jvedder/Biploar-power-supply-KiCAD/cnc/Original Carbide Copper Output/Carbide-Copper-image.png

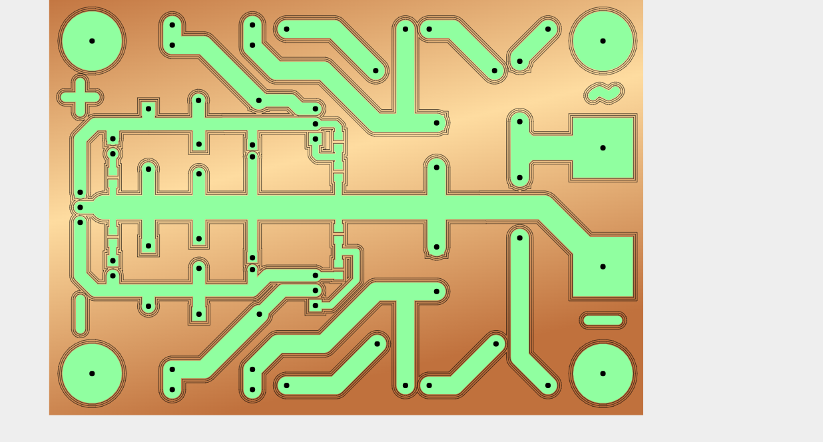
cnc/Original Carbide Copper Output/Carbide-Copper-image.png
