jvedder/Biploar-power-supply-KiCAD/README.md

# Biploar-power-supply-KiCAD
A KiCAD PCB project for a simple linear bipolar power supply (+/-15V) from a 24V single-phase transformer.

This is a work in progress.  

MIT License
