jvedder/Biploar-power-supply-KiCAD/pdf/Bipolar power supply assembly.pdf

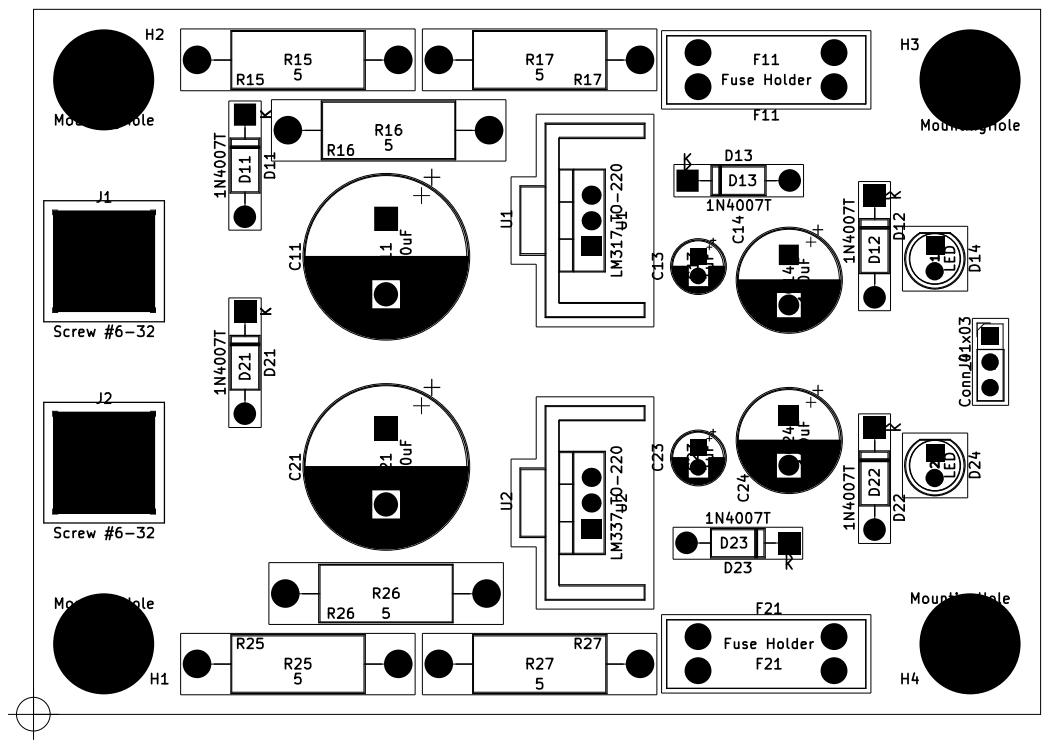
[picture p2: page 1]
