jvedder/Biploar-power-supply-KiCAD/pdf/Bipolar power supply pcb.pdf

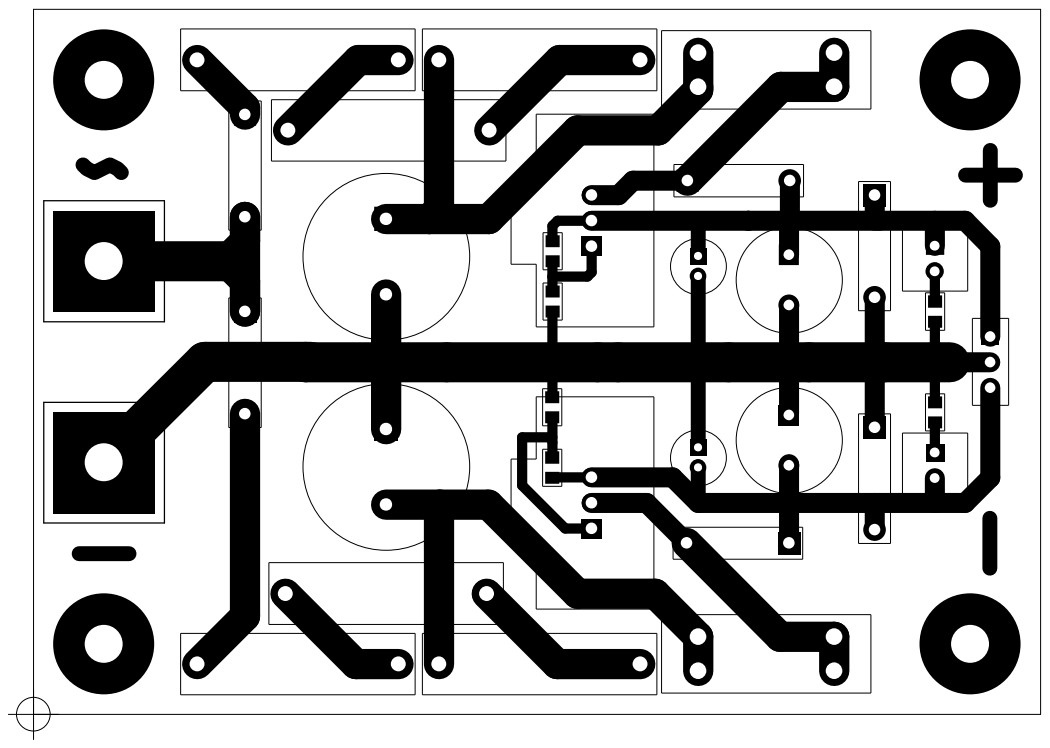
[picture p3: page 1]
