jvedder/Biploar-power-supply-KiCAD/pdf/Bipolar power supply schematc.pdf

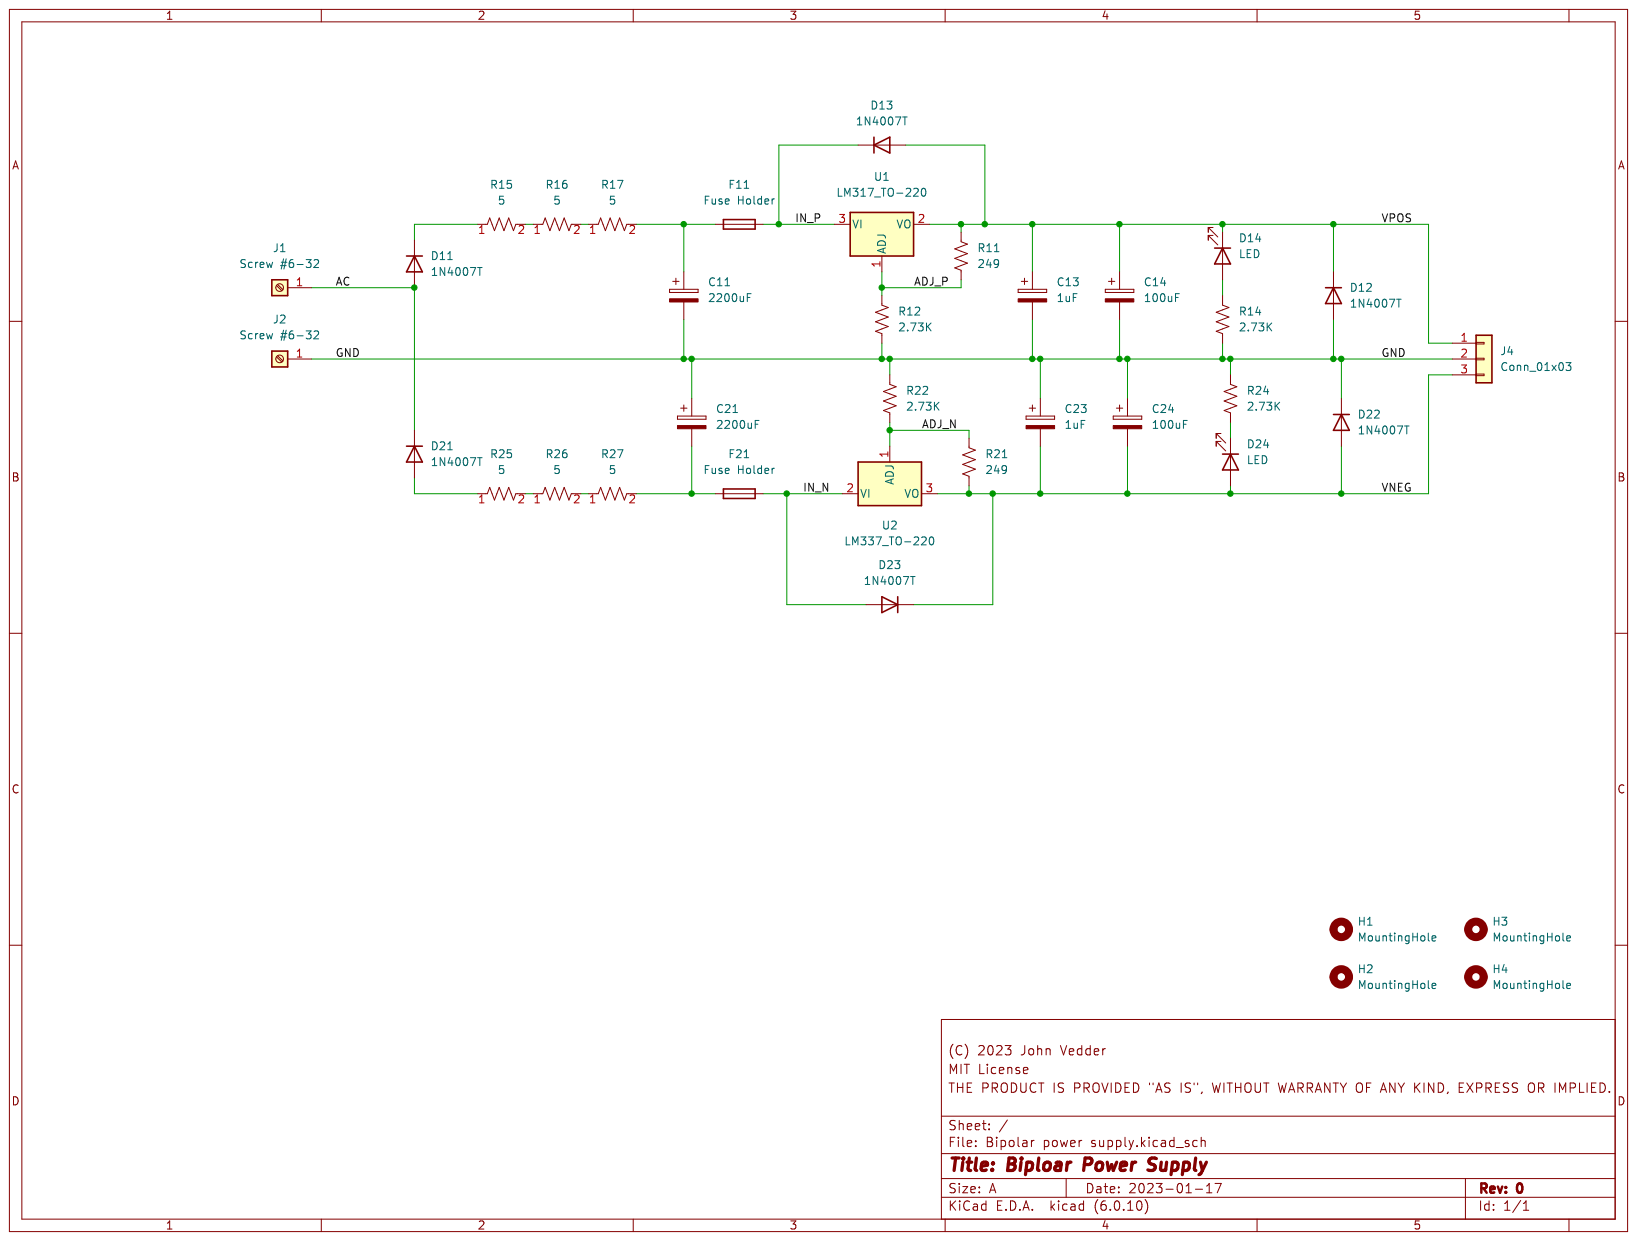
[picture p4: page 1]
