jvedder/Biploar-power-supply-KiCAD/LTSpiceXVII/Parameteric Half-wave Rectifier test current source load.asc

.RIN2: res; {RIN}
C1: cap; 2200µF; V=50V Irms=3.375 Rser=60m
C2: cap; 2200µF; V=50V Irms=3.375 Rser=60m
C3: cap; 100µF
D1: diode; 1N4007
D2: diode; 1N4007
D3: diode; 1N4007
I1: current; {IOUT}
R1: res; 125
R2: res; {(VOUT * 100) - 125}
RIN: res; {RIN}
RL1: res; {VOUT / IOUT}
U1: LT317A
V1: voltage; SINE(0 {AC_PEAK} 60)
Named nets: 0, OUT, IN, AC, ADJ, PRE, IN2, PRE2
1000V 1A
.tran 1s
.param AC_RMS=27.5V
.param AC_PEAK={AC_RMS * SQRT(2)}
.param VOUT=15V
.param IOUT=250mA
.param RIN=15
.meas PARAM_R2_VALUE PARAM ((VOUT*100)-125)
.meas PARAM_AC_RMS PARAM AC_RMS
.meas PARAM_AC_PEAK PARAM AC_PEAK
.meas PARAM_VOUT PARAM VOUT
.meas PARAM_IOUT PARAM IOUT
.meas PARAM_RIN PARAM RIN
.meas U1_Pwr AVG V(ADJ)*Ix(U1:ADJ)+V(OUT)*Ix(U1:OUT)+V(IN)*Ix(U1:IN) FROM 0.9S TO 1S
.meas RIN_Pwr AVG V(PRE,IN)*I(RIN) FROM 0.9S TO 1S
.meas C1_Vpp PP V(IN) FROM 0.9S TO 1S
.meas C1_Ipp PP I(C1) FROM 0.9S TO 1S
.meas C1_Imax MAX I(C1)
.meas D1_Imax MAX I(D1)
.meas D1_Ipp PP I(D1) FROM 0.9S TO 1S
.meas D1_Pwr AVG V(AC,PRE)*I(D1) FROM 0.9S TO 1S
.meas D1_Iavg AVG I(D1) FROM 0.9S TO 1S
.meas IN_VMIN MIN V(IN) FROM 0.9S TO 1S
.meas IN_VMAX MAX V(IN) FROM 0.9S TO 1S
.meas IN_Vpp PP V(IN) FROM 0.9S TO 1S
.meas IN_Vavg AVG V(IN) FROM 0.9S TO 1S
.meas OUT_Vavg AVG V(OUT) FROM 0.9S TO 1S
.meas OUT_Iavg AVG I(RL1) FROM 0.9S TO 1S
.meas DROPOUT_Vmin PARAM IN_VMIN - VOUT
.meas DROPOUT_Vavg PARAM IN_VAVG - VOUT
Old Furnace transformer
Name plate 24V, 40VA
Fluke Measures 27.3V AC out
Scope measures 78.4V pk-pk = 39.2V pk = 27.5V RMS
 
Old Alarm Transformer
Name plate 16.5VAC 35VA
Fluke Measures 19.0V AC out
Scope measures 54,4V pk-pk = 27.2V pk = 19.23V RMS
.model 1N4007 d is = 1.43733E-008 n = 1.80829 rs = 0.0414712
+ eg = 1.11 xti = 3 tnom = 27
+ cjo = 2.8119E-011 vj = 0.700053 m = 0.346714 fc = 0.5
+ tt = 4.10886E-006 bv = 1100 ibv = 10 af = 1 kf = 0
1000V 1A
