jvedder/Biploar-power-supply-KiCAD/LTSpiceXVII/Parameteric Half-wave Rectifier with IdealRegulator.asc

C1: cap; 2200µF
C2: cap; 2200µF
C3: cap; 100µF
D1: schottky; RB068LAM100
R1: res; 125
R2: res; {(VOUT * 100) - 125}
R3: res; {RIN}
RL1: res; {VOUT / IOUT}
V1: voltage; SINE(0 {AC_PEAK} 60)
X1: IdealPosRegulator
Named nets: 0, OUT, IN, AC, ADJ, PRE
100V 2A
.tran 1S
.param AC_RMS=27.5V
.param AC_PEAK={AC_RMS * SQRT(2)}
.param VOUT=15V
.param IOUT=0.250A
.param RIN=10ohm
.meas PARAM_R2_VALUE PARAM ((VOUT*100)-125)
.meas PARAM_AC_RMS PARAM AC_RMS
.meas PARAM_AC_PEAK PARAM AC_PEAK
.meas PARAM_VOUT PARAM VOUT
.meas PARAM_IOUT PARAM IOUT
.meas PARAM_RIN PARAM RIN
.meas X1_Pwr AVG V(ADJ)*Ix(X1:ADJ)+V(IN)*Ix(X1:IN)+V(OUT)*Ix(X1:OUT) FROM 250mS TO 500mS
.meas R3_pwr AVG V(PRE,IN)*I(R3) FROM 0.9S TO 1S
.meas C1_Vpp PP V(IN) FROM 0.9S TO 1S
.meas C1_Ipp PP I(C1) FROM 0.9S TO 1S
.meas C1_Imax MAX I(C1)
.meas D1_Imax MAX I(D1)
.meas IN_VMIN MIN V(IN) FROM 0.9S TO 1S
.meas IN_VMAX MAX V(IN) FROM 0.9S TO 1S
.meas IN_Vpp PP V(IN) FROM 0.9S TO 1S
.meas IN_AVG AVG V(IN) FROM 0.9S TO 1S
.meas OUT_VAVG AVG V(OUT) FROM 0.9S TO 1S
.meas OUT_IAVG AVG I(RL1) FROM 0.9S TO 1S
.meas DROPOUT param {IN_VMIN - VOUT}
Old Furnace transformer
Name plate 24V, 40VA
Fluke Measures 27.3V AC out
Scope measures 78.4V pk-pk = 39.2V pk = 27.5V RMS
 
Old Alarm Transformer
Name plate 16.5VAC 35VA
Fluke Measures 19.0V AC out
Scope measures 54,4V pk-pk = 27.2V pk = 19.23V RMS
