jvedder/Biploar-power-supply-KiCAD/Bipolar power supply.kicad_pcb

## KiCad design Bipolar power supply.kicad_pcb (2023-01-18)

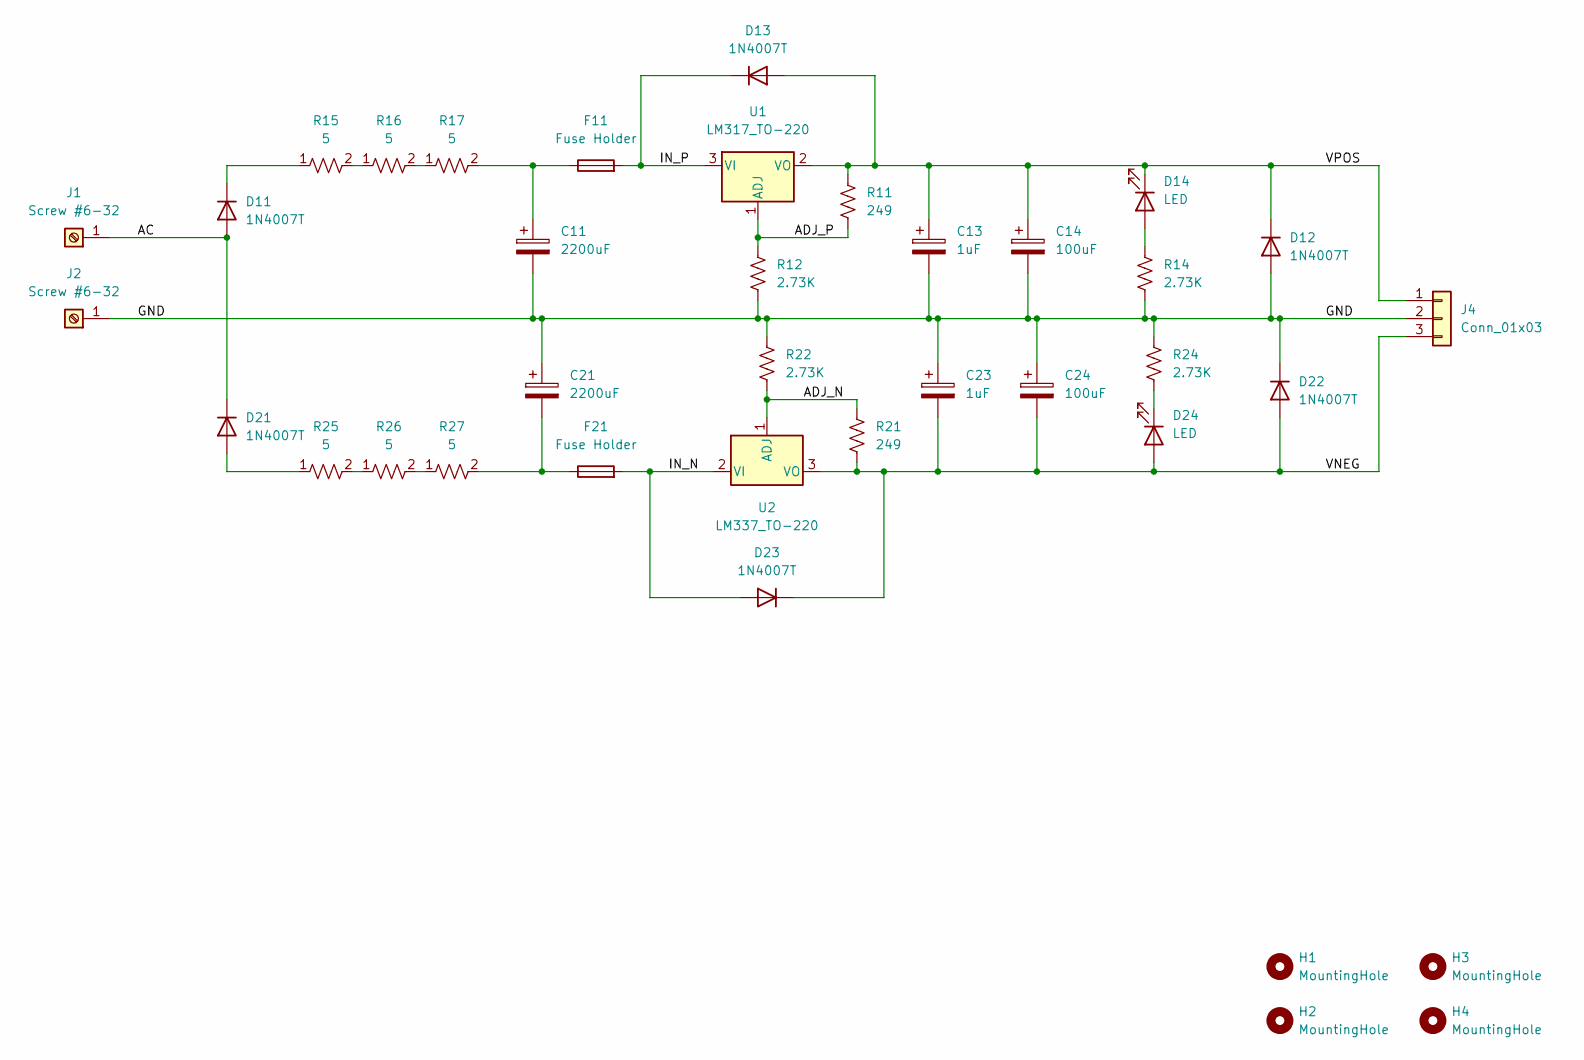
[picture p5: schematic Bipolar power supply.kicad_sch, Biploar Power Supply]

Parts:
C11, C21: 2200uF; CP_Radial_D16.0mm_P7.50mm
C13, C23: 1uF; CP_Radial_D5.0mm_P2.00mm
C14, C24: 100uF; CP_Radial_D10.0mm_P5.00mm
D11, D12, D13, D21, D22, D23: 1N4007T; D_DO-41_SOD81_P10.16mm_Horizontal
D14, D24: LED; LED_D5.0mm
F11, F21: Fuse Holder; FuseHolder_6.8x19.8mm_P3.4x13.5mm_Vetical
H1, H2, H3, H4: MountingHole; MountingHole_#6-32_Pad_10mm
J1, J2: Screw #6-32; ScrewTerminal_01x01_#6-32_10mm
J4: Conn_01x03; PinHeader_1x03_P2.54mm_Vertical
R11, R21: 249; R_0805_2012Metric_Pad1.20x1.40mm_HandSolder
R12, R14, R22, R24: 2.73K; R_0805_2012Metric_Pad1.20x1.40mm_HandSolder
R15, R16, R17, R25, R26, R27: 5; R_Axial_L13.1mm_D5.6mm_P20.0mm_Horizontal
U1: LM317_TO-220; TO-220-3_Vertical_Heatsink_19.1x9.7mm
U2: LM337_TO-220; TO-220-3_Vertical_Heatsink_19.1x9.7mm

Connections:
/AC: D11.2 (A), D21.1 (K), J1.1
/ADJ_N: R21.1, R22.2, U2.1 (ADJ)
/ADJ_P: R11.2, R12.1, U1.1 (ADJ)
/GND: C11.2, C13.2, C14.2, C21.1, C23.1, C24.1, D12.2 (A), D22.1 (K), J2.1, J4.2, R12.2, R14.2, R22.1, R24.1
/IN_N: D23.2 (A), F21.2, U2.2 (VI)
/IN_P: D13.1 (K), F11.2, U1.3 (VI)
/VNEG: C23.2, C24.2, D22.2 (A), D23.1 (K), D24.2 (A), J4.3, R21.2, U2.3 (VO)
/VPOS: C13.1, C14.1, D12.1 (K), D13.2 (A), D14.1 (K), J4.1, R11.1, U1.2 (VO)
unnamed: C11.1, F11.1, R17.2
unnamed: C21.2, F21.1, R27.2
unnamed: D14.2 (A), R14.1
unnamed: D24.1 (K), R24.2
unnamed: D11.1 (K), R15.1
unnamed: R15.2, R16.1
unnamed: R16.2, R17.1
unnamed: D21.2 (A), R25.1
unnamed: R25.2, R26.1
unnamed: R26.2, R27.1

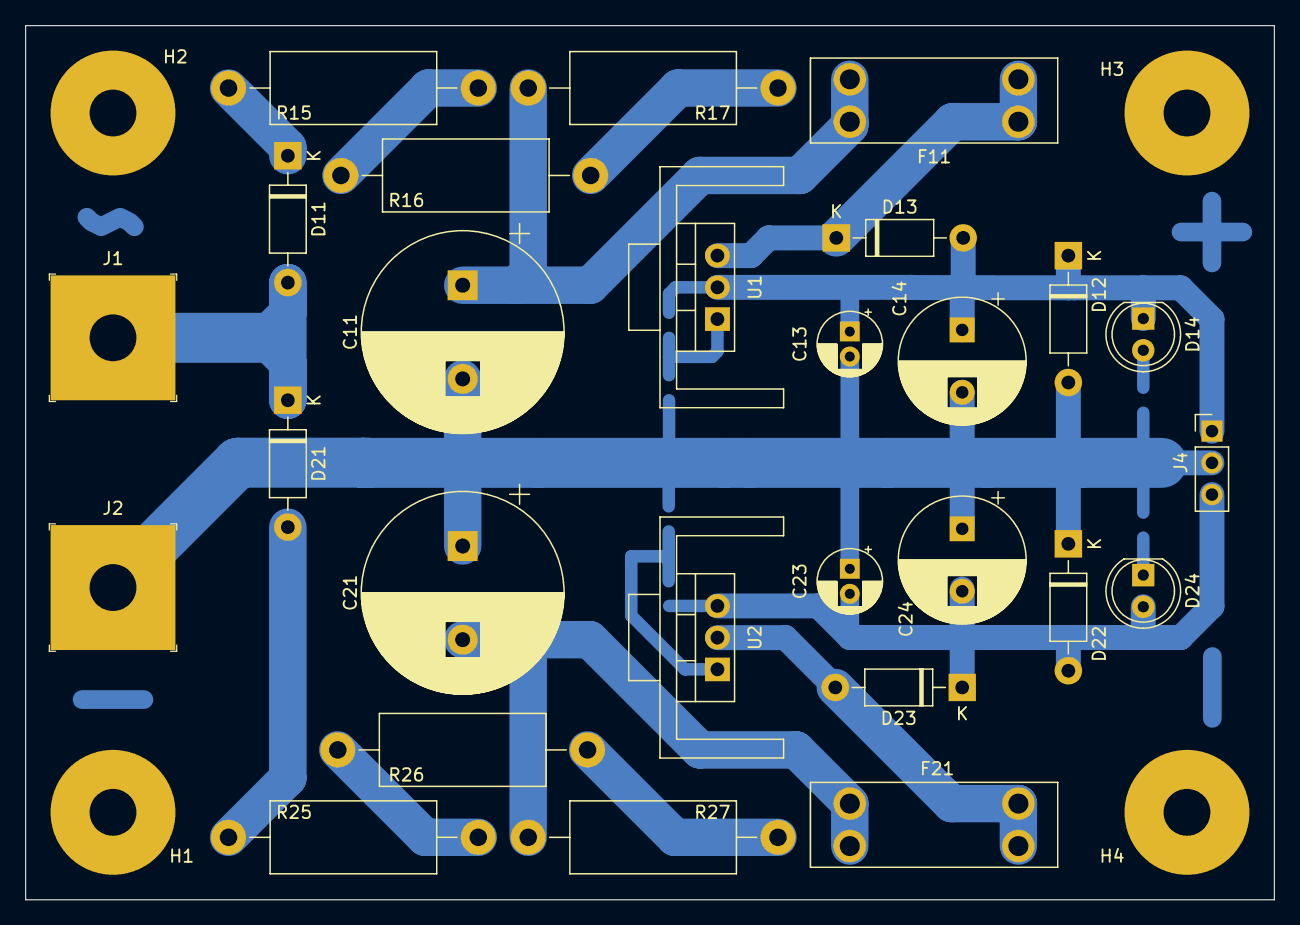
[picture p6: board Bipolar power supply.kicad_pcb from above]

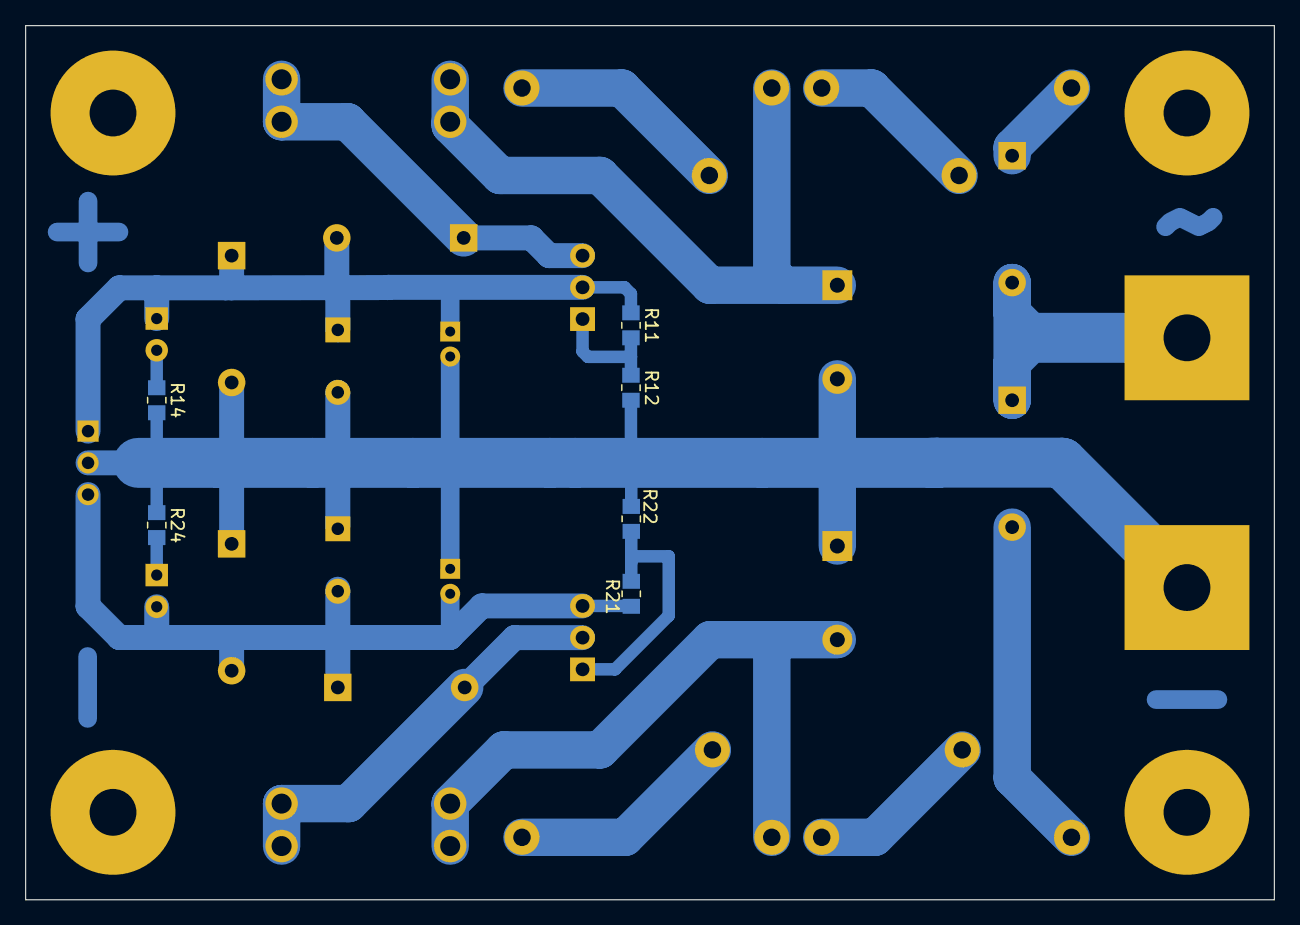
[picture p7: board Bipolar power supply.kicad_pcb from below]

Board: 2 copper layers, 100.0 x 70.0 mm, 37 parts (6 on the bottom side), 18 nets.
