jvedder/Biploar-power-supply-KiCAD/cnc/Original Carbide Copper Output/Carbide-Copper-Setup-03.png

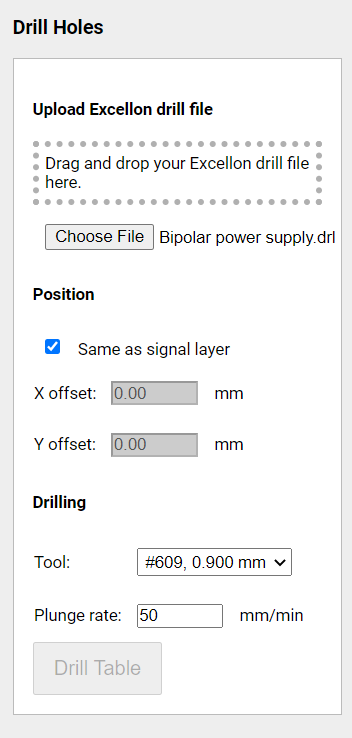
cnc/Original Carbide Copper Output/Carbide-Copper-Setup-03.png
