jvedder/Biploar-power-supply-KiCAD/(commit log)

2023-01-07 Intial design
    [Bipolar power supply.kicad_pcb, Bipolar power supply.kicad_sch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]
2023-01-08 Update spice measurements for dropout voltage
2023-01-09 Revised schematic for (1) bridge rectifiers, (2) three power resistors, and (3) fuse holders.
    [Bipolar power supply.kicad_pcb, Bipolar power supply.kicad_sch]
2023-01-10 First pass at routing in 70x100 mm panel.
    [Bipolar power supply.kicad_pcb, Bipolar power supply.kicad_sch]
2023-01-10 Created footprint for TO-220 with Heatsink
    [Bipolar power supply.kicad_pcb, Bipolar power supply.kicad_sch]
2023-01-11 Routing WIP.
    [Bipolar power supply.kicad_pcb, Bipolar power supply.kicad_sch]
2023-01-14 Routing done. Used for dry fit.
    [Bipolar power supply.kicad_pcb]
2023-01-14 Updated footprints from dry fit.
    [Bipolar power supply.kicad_pcb, Bipolar power supply.kicad_sch]
2023-01-15 Added LEDs and edge clearance. Rerouted.
    [Bipolar power supply.kicad_pcb, Bipolar power supply.kicad_sch]
2023-01-15 Switched to non-CT transformer. Redesigned and rerouted.
    [Bipolar power supply.kicad_pcb, Bipolar power supply.kicad_sch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]
2023-01-15 Created output fab and CNC files
    [Bipolar power supply-B_Cu.gbr, Bipolar power supply-Edge_Cuts.gbr, Bipolar power supply-job.gbrjob, Bipolar power supply.drl]
2023-01-17 Add drill map
    [Bipolar power supply-PTH-drl-drl_map.gbr]
2023-01-18 add hand-made CNC files for adding additional output connector and back plastic
2023-01-18 Update title blocks. Made PDFs
    [Bipolar power supply.kicad_pcb, Bipolar power supply.kicad_sch]
