jvedder/Biploar-power-supply-KiCAD/(notices)

Notices in the files:
Bipolar power supply.kicad_pcb:
(C) 2023 John Vedder
